MusaCanBacak/ExtraKeyboard-MK1/varliklar/simge-1024.png

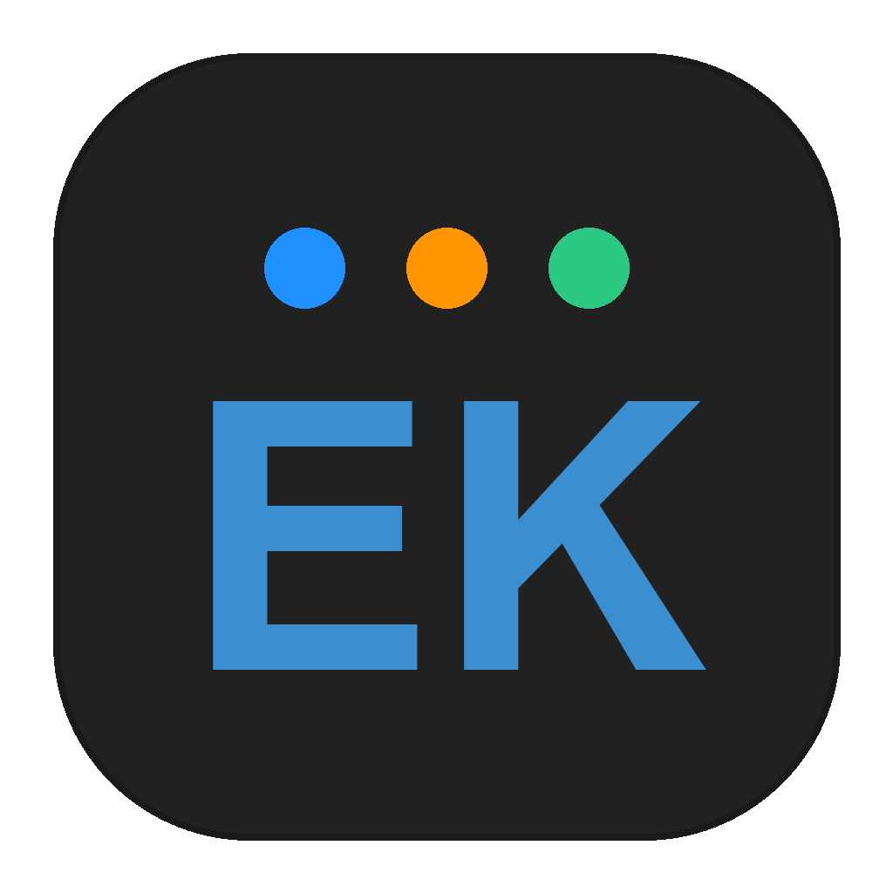
varliklar/simge-1024.png
