MusaCanBacak/ExtraKeyboard-MK1/hardware/BOM.csv

Kategori | Parça | Açıklama | Adet | Örnek Parça No | Tahmini Birim Fiyat (TL) | Toplam (TL) | Not
MCU | ESP32-S3-DevKitC-1 | ESP32-S3-WROOM-1 N16R8 modül; 16 MB flash + 8 MB octal PSRAM; yerleşik USB OTG; 2 port (klonlarda USB-C, resmî Espressif kartta Micro-B) | 1 | ESP32-S3-DevKitC-1-N16R8 | 750.00 | 750.00 | N16R8 (16 MB flash + 8 MB Octal PSRAM) önerilir; N8R2 (8 MB flash + 2 MB Quad PSRAM) da çalışır. Hazır firmware yükleyicisi modülü kendisi tanıyıp doğru imajı yazar. Kaynaktan derlerken ortam modüle göre seçilir (n16r8 / quad); yanlış ortam kartı açılmaz hâle getirir.
Anahtar | Cherry MX Blue anahtar | 3 pinli plate-mount clicky (tıklı) mekanik anahtar; 50 g tetikleme; iki parçalı slider (gövde içinde ayrı click jacket); ön hareket 2.2 mm / toplam hareket 4.0 mm | 12 | MX1A-E1NN | 38.00 | 456.00 | Numpad için 16 adet. Birim fiyat MX Brown ile aynıdır (~38 TL). Uyumlu alternatifler: Gateron Blue (~28 TL); Kailh Box White (click bar mekanizması, toza/suya daha dayanıklı); Outemu Blue (en ucuz, kalite değişken). PCB olmadığından 5 pinli versiyon da olur: gövde altındaki 2 plastik ayak boşta kalır. Plaka deliği modelde 14.15 mm kare (14.00 + FDM payı), adım 19.05 mm.
Tuş Başlığı | PBT çift kat keycap 1U | OEM veya Cherry profil; 19.05 mm adım; çift kat baskı silinmez | 12 | - | 26.00 | 312.00 | MX uyumlu herhangi bir tuş başlığı olur. Numpad için 16 adet. Bu projede tuş altı aydınlatma yoktur; şeffaf gerekmez.
Enkoder | EC11 döner enkoder | 20 detent / tur; M7 dişli burç; 15 mm D-shaft; entegre push buton; 5 pinli | 1 | EC11E18244AU | 45.00 | 45.00 | Plaka deliği ⌀7.20 mm. Enkoder gövdesi plakanın iç yüzündeki cebe oturur, dış yüzden somunla sıkılır; somunu ve pulu kutudan çıkmalıdır. Düğmesi baskıdır (mechanical/stl/enkoder-dugmesi.stl). Numpadde yoktur.
LED | Düz LED 3 mm (tek renk) | Difüze yuvarlak; durum göstergesi | 3 | - | 2.00 | 6.00 | Plakadaki LED penceresi ⌀3.20 mm; LED iç yüzdeki ışık bölmesine oturur. Her LED kendi GPIO'suna 330 Ω üzerinden: LED1 GPIO14 (Windows), LED2 GPIO42 (macOS), LED3 GPIO41 (COMBO). Uzun bacak (anot) dirence, kısa bacak (katot) GND'ye. Renk serbest. Numpad için 2 adet (GPIO42 Windows, GPIO41 macOS). (Projenin ilk sürümü 3 x WS2812B kullanıyordu; güncel firmware düz LED sürer.)
Pasif | 10 kΩ direnç | 1/4 W metal film %1; enkoder RC filtresi pull-up direnci | 2 | CFR-25JB-52-10K | 1.00 | 2.00 | ENC_A ve ENC_B için birer adet. 100 nF ile birlikte τ = 1 ms verir.
Pasif | 100 nF seramik kondansatör | 50 V X7R; 2.54 mm bacak aralığı; enkoder RC filtresi | 2 | K104K15X7RF5UH5 | 2.00 | 4.00 | ENC_A ve ENC_B için birer adet. Polaritesizdir.
Pasif | 330 Ω direnç | 1/4 W karbon film %5; her LED için bir akım sınırlama direnci | 3 | CFR-25JB-52-330R | 1.00 | 3.00 | Her LED'in anot tarafına seri bağlanır (3 LED = 3 direnç; numpadde 2).
Pasif | Delikli pertinaks kart 20 x 30 mm | RC debounce devresini üzerine kurmak için; 2.54 mm delik adımı | 1 | - | 15.00 | 15.00 | Havadan lehimleme yerine küçük bir kart kullanmak enkoder filtresini çok daha güvenilir kılar. Numpadde gerekmez.
Kablo | USB-C ↔ USB-A veri kablosu 1 m | USB 2.0 veri hatlı; örgülü kılıf tercih edilir | 1 | - | 120.00 | 120.00 | Şarj-only kablo KULLANILAMAZ; cihaz açılır ama PC hiç görmez. Kartın portu Micro-B ise kabloyu Micro-B uçlu alın. Kart üzerindeki native 'USB' portuna takılır, 'UART' portuna DEĞİL.
Kablo | 26 AWG silikon kaplı tel | 7 renk x 2 m (siyah/sarı/yeşil/mavi/turuncu/beyaz/kırmızı); çok telli esnek iletken; 200 °C silikon izolasyon | 1 | - | 150.00 | 150.00 | Klavyede 18 sinyal teli (12 tuş + enkoder 3 + LED 3), ortak GND zinciri ve enkoder filtresi için 3V3 teli. Plaka açılıp kapanabilsin diye teller biraz uzun bırakılır; ~2 m yeter, 14 m fazlasıyla yeter. Bağlantılar: docs/BASIT-YAPIM.md bölüm 5 ve EK A.
Kablo | Isı ile daralan makaron seti | ⌀2 / 3 / 4 / 5 mm; 2:1 daralma oranı; karışık renk | 1 | - | 35.00 | 35.00 | LED dirençlerinin ve tel eklerinin yalıtımı için.
Mekanik | M2 vida 6-8 mm | Yıldız başlı; plastiğe diş açan (self-tapping) ya da düz M2 vida | 4 | - | 2.00 | 8.00 | Üst plakayı 4 köşeden gövdedeki takozlara tutar (⌀2.00 pilot delik, ~5 mm derin). Plakadaki delik dar gelirse 2.2-2.4 mm matkapla genişletin. Heat-set insert gerekmez.
Mekanik | Silikon ayak ⌀8 x 2 mm | Kendinden yapışkanlı; kaymaz | 4 | - | 4.00 | 16.00 | Tabanın dört köşesine. Cihazın masada kaymasını ve çizmesini önler. MX Blue ile ayrıca akustik görevi vardır: gövde-masa yapısal temasını keser, masa tablasının rezonatör gibi davranmasını engeller.
Akustik | Poron/EVA sünger levha 3 mm | 100 x 100 mm levha; plaka altı kovuk dolgusu ve taban iç yüzeyi kaplaması için kesilir | 1 | - | 40.00 | 40.00 | MX Blue ile ÖNERİLİR. Plaka altındaki boş kovuk (önde ~13.5 mm, arkada ~27.5 mm yükseklik) rezonans odası gibi çalışır; sünger olmadan tık sesi çınlamalı/boşluklu (hollow, pingy) çıkar. Kovuğu DevKit'i ve kabloları SIKIŞTIRMADAN gevşekçe doldurun; ayrıca tabanın iç yüzeyine 2-3 mm sünger yapıştırın. Kesilmiş mutfak dolabı kaymaz altlığı da aynı işi görür.
Mekanik | PETG filament ~100 g | Gövde + üst plaka + enkoder düğmesi baskısı (mechanical/stl/); 0.2 mm katman | 1 | - | 92.00 | 92.00 | Modellerin dolu hacmi ~75 cm³ (~96 g PETG); 3 mm duvar ve plaka büyük ölçüde dolu basılır. Gövde dışı 94.20 x 105.15 mm, yükseklik 19 -> 33 mm; plaka 87.85 x 99.77 x 3.00 mm. PLA da olur ancak PETG sıcakta deforme olmaz.
Sarf | Lehim teli 0.8 mm 100 g | Sn60Pb40 reçineli; veya kurşunsuz Sn99.3Cu0.7 | 1 | - | 165.00 | 165.00 | 0.8 mm çap bu ölçekteki işler için idealdir; 1.0 mm kalın kalır.
Sarf | Flux kalemi / lehim pastası | No-clean reçine bazlı | 1 | - | 60.00 | 60.00 | Özellikle DevKit pinlerinde soğuk lehimi önler.
TOPLAM | ZORUNLU MALZEME TOPLAMI | Cihazı çalışır hale getirmek için gereken her şey (alet hariç) | 1 | - | 2279.00 | 2279.00 | 18 kalem. Fiyatlar 2026 Ağustos Türkiye perakende tahminidir; toptan alımda %25-35 düşer. Enkoder düğmesi filament kalemine dahildir. Numpad: 16 anahtar + 16 tuş başlığı, 2 LED + 2 direnç; enkoder, RC filtre parçaları ve küçük kart gerekmez.
Opsiyonel | Hazır alüminyum enkoder düğmesi ⌀25 mm | 6 mm mil; setuskurlu; tırtıklı yan yüzey | 1 | - | 90.00 | 90.00 | Baskı düğme (enkoder-dugmesi.stl) yerine. Plastik hazır düğme ~25 TL'dir; alüminyum düğme cihazın algılanan kalitesini belirgin biçimde yükseltir.
Opsiyonel | Yedek Cherry MX Blue anahtar | Ana anahtarla birebir aynı: 3 pinli plate-mount clicky; 50 g. Montaj sırasında zarar görme ihtimaline karşı | 2 | MX1A-E1NN | 38.00 | 76.00 | Anahtar pinini kırmak montajda en sık yapılan hatadır. Yedeği de MX Blue alın; tek bir taktil/lineer anahtar diğer tuşlardan farklı hissedilir ve duyulur.
TOPLAM | OPSİYONEL MALZEME TOPLAMI | Zorunlu değil; iyileştirme ve alternatif kalemler | 1 | - | 166.00 | 166.00 | 2 kalem. Zorunlu değil; iyileştirme ve yedek kalemler.
Alet | Ayarlanabilir sıcaklık havya istasyonu | 60 W; 200-450 °C; konik + keski uç | 1 | - | 900.00 | 900.00 | Bir kerelik yatırım.
Alet | Dijital multimetre | Direnç / gerilim / süreklilik / diyot testi modları | 1 | - | 450.00 | 450.00 | Güç vermeden önceki kısa devre kontrolü (docs/BASIT-YAPIM.md bölüm 6, adım 9) ve tuş süreklilik testi için şart.
Alet | Yan keski + tel soyucu | 26-16 AWG aralığında ayarlı soyucu | 1 | - | 180.00 | 180.00 | 26 AWG silikon teli izolasyonunu ezmeden soymak için.
Alet | Üçüncü el / kart tutucu | Timsah ağızlı; ağırlıklı taban | 1 | - | 120.00 | 120.00 | Lehimleme sırasında anahtar, LED ve küçük kartı sabit tutar.
Alet | Isı tabancası | Makaron daraltmak için; 300-500 °C | 1 | - | 350.00 | 350.00 | Çakmak da iş görür ancak izolasyonu yakma riski vardır. Havya gövdesinin sıcak havası da yeterlidir.
TOPLAM | ALET TOPLAMI | Bir kerelik yatırım; her cihazda tekrar alınmaz | 1 | - | 2000.00 | 2000.00 | 5 kalem. Elinizde varsa bu tutar sıfırdır.
TOPLAM | GENEL TOPLAM | Zorunlu + Opsiyonel + Alet | 1 | - | 4445.00 | 4445.00 | 2279.00 + 166.00 + 2000.00 = 4445.00. Aletler ve opsiyoneller hariç bir adet çalışır ExtraKeyboard MK1 maliyeti: 2279.00 TL
