MusaCanBacak/ExtraKeyboard-MK1/mechanical/plate.dxf

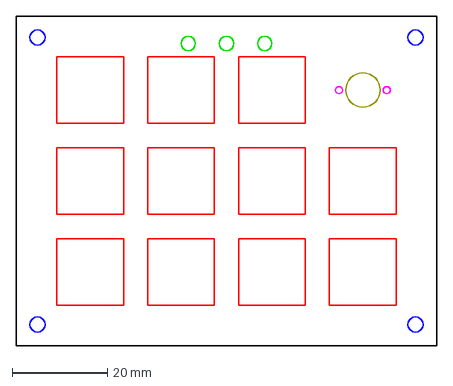
[picture p9: CAD file, 2026-10-14]
mechanical/plate.dxf
88.2 x 69.2 mm
