MusaCanBacak/ExtraKeyboard-MK1/mechanical/stl/ust-plaka-numpad.stl

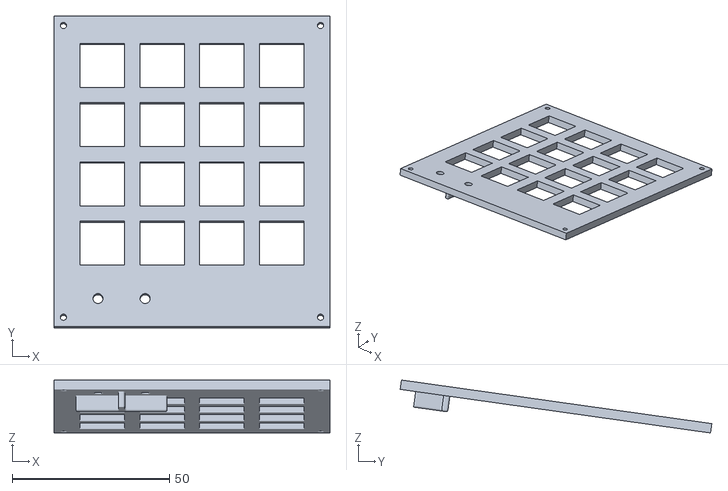
[picture p10: CAD file, 2026-10-22]
mechanical/stl/ust-plaka-numpad.stl
87.8 x 99.2 x 16.9
