MusaCanBacak/ExtraKeyboard-MK1/mechanical/stl/enkoder-dugmesi.stl

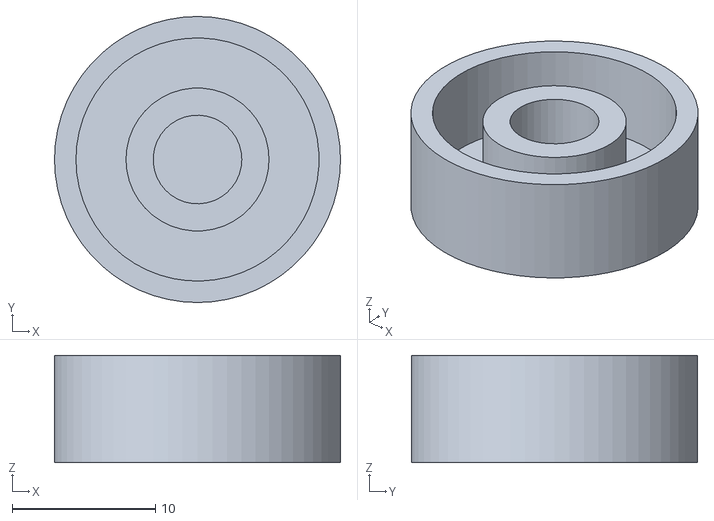
[picture p11: CAD file, 2026-10-22]
mechanical/stl/enkoder-dugmesi.stl
20.0 x 20.0 x 7.50
