MusaCanBacak/ExtraKeyboard-MK1/mechanical/stl/ust-plaka-klavye.stl

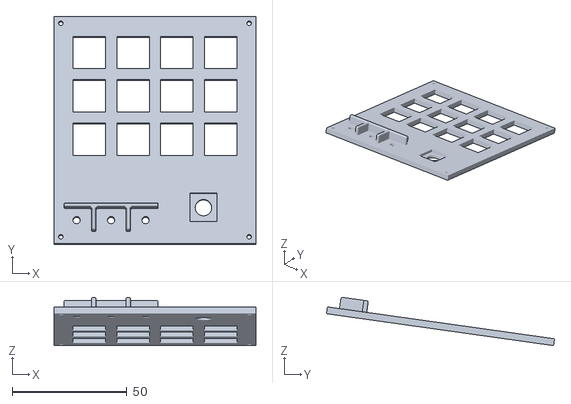
[picture p12: CAD file, 2026-10-22]
mechanical/stl/ust-plaka-klavye.stl
87.8 x 99.2 x 21.0
