MusaCanBacak/ExtraKeyboard-MK1/mechanical/stl/govde.stl

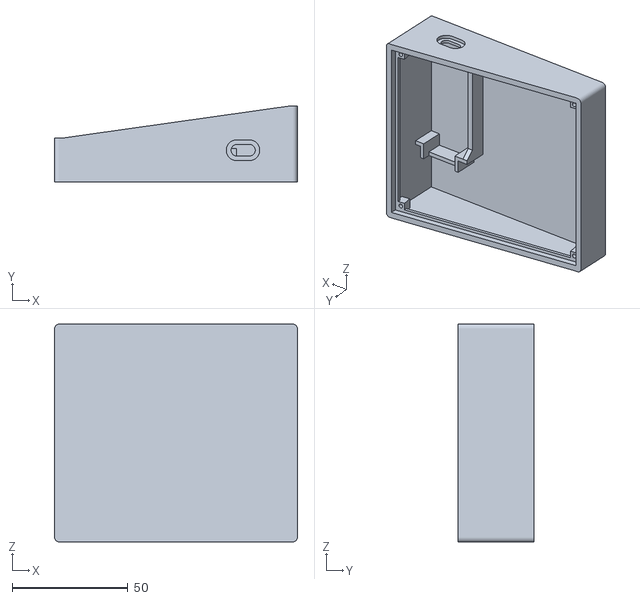
[picture p13: CAD file, 2026-10-22]
mechanical/stl/govde.stl
105.2 x 33.0 x 94.2
