MusaCanBacak/ExtraKeyboard-MK1/(commit log)

2026-10-14 ExtraKeyboard MK1 — ilk yedek
    Firmware (klavye: firmware/, numpad: firmware-numpad/), masaüstü
    uygulaması (app/), yükleme ve tanılama araçları (tools/), belgeler
    (docs/), donanım ve mekanik tasarım dosyaları.
    Depo dışında tutulanlar (.gitignore): derleme çıktıları (build/, dist/,
    .pio/), sanal ortam (.venv/), elle alınmış .bak yedekleri, dağıtım
    zip'leri ve telefon sunucusu erişim jetonunu içeren config.json.
    Güncel kurulum paketi GitHub Release eki olarak ayrıca saklanır.
    [BOM.csv, assembly.scad, case.scad, knob.scad, parameters.scad, plate.dxf, plate.scad]
2026-10-22 README: ekran görüntüleri, güncel yapım kılavuzu; belgeler güncel donanıma uyarlandı
    - README yeniden yazıldı: uygulamanın 7 ekran görüntüsü (örnek atamalarla),
    klavye ve numpad varyantları, malzeme, kablolama, gövde, firmware yükleme
    (birim ortamları + DIO/40 MHz kuralı + kutusuz güncelleme), uygulama kurulumu,
    sorun giderme ve doğru belge bağlantıları.
    - firmware/platformio.ini: kendi N16R8'li yapımlar için genel [env:n16r8]
    (takassız). Üç ortamın tuş eşlemesi ikili dosyada doğrulandı.
    - PIN-HARITASI.md: üst sıra eşlemesinin birime göre değiştiği düzeltildi
    ("5 klavyede geçerli" notu yanlıştı); bellek/flash bölümü güncellendi.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
    [BOM.csv]
2026-10-22 Güncel firmware imajları ve yükleyici; lisans (PolyForm NC + CC BY-NC-SA)
    Firmware dosyaları:
    - Eski derlemeler kaldırıldı: firmware-numpad/firmware-numpad.bin, bakımı
    kesilmiş Arduino IDE kopyası (dagitim/firmware-arduino) ve tek dosyalık
    dagitim/ExtraKeyboard-Firmware-main.cpp. Güncel imajlar Release ekinde.
    - tools/imaj-olustur.py: dört genel varyantı (klavye/numpad x N16R8/N8R2)
    derler, DIO/40 MHz başlıklı tek imaja birleştirir ve doğrular.
    - dagitim/ExtraKeyboard-Firmware: yukle.py (macOS/Windows/Linux) + çift
    tıklanan başlatıcılar. Kartı USB kimliğinden bulur, kutuyu açmadan indirme
    moduna alır, modülü esptool ile tanır, NVS'i koruyarak yazar,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
2026-10-22 BASIT-YAPIM güncel donanıma uyarlandı; gövde ve plaka STL'leri eklendi
    - mechanical/stl/: gövde, klavye ve numpad üst plakaları, enkoder düğmesi
    (gerçek birimlerin 3D modelleri; tuş başlığı dosyaları dahil edilmedi,
    MX uyumlu herhangi bir tuş başlığı olur).
    - docs/BASIT-YAPIM.md yeniden yazıldı, ölçüler modellerden okundu: plaka
    87.85 x 99.77 x 3.00 mm, 4x3 tuş + arka şeritte enkoder ve 3 LED (ışık
    bölmeli), numpad 4x4; gövde ön 19 / arka 33 mm, 8 derece, plaka 4 köşe
    vidasıyla takozlara, ESP32 gövdedeki cepte, USB açıklığı 14.47 x 9.00 mm.
    Kablolama 12 tuşlu varsayılan GPIO eşlemesine ve düz LED devresine göre;
    WS2812B, delikli k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
    [enkoder-dugmesi.stl, govde.stl, ust-plaka-klavye.stl, ust-plaka-numpad.stl]
2026-10-22 BOM güncel donanıma uyarlandı
    - M3 vida + heat-set insert yerine 4 x M2 vida (plaka köşe takozlarına).
    - LED 5 mm -> 3 mm (plakadaki pencere ⌀3.2); hazır alüminyum düğme
    opsiyonele taşındı, düğme artık baskı (enkoder-dugmesi.stl).
    - PETG ~120 g -> ~100 g (modellerin dolu hacmi ~75 cm³); ölçüler gerçek
    gövde/plakaya göre; 42 tel, 1.50 mm plaka, diyot ve spesifikasyon 2.1
    atıfları kaldırıldı; numpad adetleri notlara eklendi.
    - İlk tasarıma ait opsiyoneller (difüzör çubuğu, hot-swap soket, akrilik
    plaka) çıkarıldı. Zorunlu toplam 2409 -> 2279 TL, genel 4858 -> 4445 TL.
    - README malzeme tablosu ve BASIT-YAPIM sünger notu BOM ile eşitlendi.
    Co-A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
    [BOM.csv]
2026-10-22 Kurulum paketi: 3-DONANIM'e yapım kılavuzu ve baskı dosyaları
    - 3-DONANIM/OKU-ONCE.txt: BASIT-YAPIM.md ve stl/ klasörünü gösteriyor; güncel
    ve ilk tasarıma ait belgeler ayrıldı.
    - BASLA-BURADAN.txt klasör listesi yeni içeriğe göre.
    Sürüm kurulum-2026-10-22'deki KURULUM.zip bu iskeletle yeniden üretildi:
    3-DONANIM'e BASIT-YAPIM.md ve stl/ (4 dosya) eklendi, belgeler güncel
    sürümleriyle değişti; paket içi bağlantılar pakete ya da GitHub'a çevrildi.
